jiajun1223/1234/docs/02_壁厚与斜度设计.md

# 壁厚与斜度设计

## 壁厚公式（谐波齿轮传动技术手册 表 3-3）
| 项目 | 公式 | 08 取值(d_RB=20) |
|---|---|---|
| 壁厚 δ | (0.0075~0.0115)·d_RB，取 0.008 | 0.16 |
| 筒壁外径 d_WR | d_RB + 2δ | 20.32 |
| 齿圈宽 b_R | (0.15~0.25)·d_RB，取 0.2 | 4.0 |
| 筒长 L | (0.75~1.0)·d_RB，取 0.8 | 16 |
| 凸缘厚 H | ≥3+0.01·d_RB | 3.2 |
| 齿根下壁厚 δ₁ | (d_fR−d_RB)/2 | 0.61 |
| 圆角 R₁=R₂ / R₃ | 0.05·d_RB / 0.10·d_RB | 1.0 / 2.0 |

## 筒壁斜度
- **0°~0.5°（以等壁为主）**，这是绿的 LCS/LHD 风格：筒体套波发生器要均匀变形，锥度>1° 会倾斜啮合区。
- 若做渐变壁厚：0.3°~0.8°，壁厚比 1.2~1.5。

## 腹板斜度
- 腹板与径向面夹角 **5°~12°（常用 6°~8°）**；两端相切 R≥3δ。

## 底盘（法兰盘）斜度 —— 见 docs/03

## 渐变壁厚原则
- 优先用**样条**（刚度二阶连续），不要"直线锥 + 小圆角"组合。
- 应力逻辑：根部（固支端）弯矩最大 → 厚；齿端需柔 → 薄。
