jiajun1223/1234/docs/05_手册与绿的LCS对标数据.md

# 手册数据与绿的 LCS 对标

## 手册 表 3-2（壁厚系数 δ/d_RB，淬火回火 HRC32~36）
| 速比 u | 合金结构钢 | 弹簧钢 | 中碳钢 |
|---|---|---|---|
| ≤80 | 0.0100 | 0.0095 | 0.0090 |
| 80~160 | 0.0095 | 0.0090 | 0.0085 |
| 160~250 | 0.0090 | 0.0085 | 0.0080 |

## 手册 表 3-3 计算实例（u=100, T=50 N·m, d_RB=60）
| 序号 | 项目 | 公式 | 值 |
|---|---|---|---|
| 1 | 柔轮内径 d_RB | k·∛(T/10) | 60 |
| 2 | 齿圈宽 b_R | (0.15~0.25)d_RB | 12 |
| 3 | 筒长 L | (0.75~1.0)d_RB | 48 |
| 4 | 壁厚 δ | (0.0075~0.0115)d_RB | 0.48 |
| 5 | 筒壁外径 d_WR | d_RB+2δ | 60.96 |
| 6 | 凸缘厚 H | ≥3+0.01d_RB | 4 |
| 8 | 端凸缘 d_T | (0.5~0.65)d_RB | 36 |
| 9~11 | 圆角 R₂/R₁/R₃ | 0.05/0.05/0.10 d_RB | 3/3/6 |
| 12 | 齿顶圆 d_aR | 2m(u+x_R+h_a*) | 62.223 (m=0.3,x_R=3.37,h_a*=0.5) |
| 13 | 齿根圆 d_fR | 2m(u+x_R−h_f*) | 61.212 (h_f*=1.35) |
| 14 | 齿根下壁厚 δ₁ | (d_fR−d_RB)/2 | 0.56 |
| 15 | 壁厚差 Δδ | δ₁−δ | 0.08 |

注：x_R 为变位系数按速比查表；h_a* 取 0.3~0.8；h_f* 滚刀 1.35 / 插齿刀 1.25。

## 绿的式柔轮剖面读数（2° 图纸）
- 壁厚 0.12（齿圈段），2° 过渡，根部加厚 0.11 → 0.23
- 齿圈段 1.7，过渡段 1.2，筒体 4.7
- 腹板 3（径向）×2（轴向）+ R2 相切，底部 R0.3
- 法兰厚 1.5，宽 1.31
- 结论：2° 只作用在约 3 mm 段（1.7+1.2），下面 4.7 段等厚；齿圈段不加厚，加厚靠锥度。

## CSF-14 参考件实测（鑫拓 CSF-14系列柔轮.SLDPRT）
- 包围盒 Ø46.97 × 35.20
- 齿顶 R17.597（Ø35.19）、齿根 R17.227（Ø34.45）
- 齿形圆弧 R0.30（齿顶凸）/ R0.15（齿侧）/ R0.134（齿根凹）
- 齿数 160（速比 80），m≈0.2177
- 其他圆柱面 R16.948 / R17.148 / R11.5 / R5.5 / R2.1×6

## DWG 08-100.dwg 解析
- 版本 r2004，8 图层，2130 实体（440 直线 / 1632 圆弧 / 8 圆 / 2 椭圆 / 2 样条 / 26 尺寸 / 10 多行文字 / 5 块 / 1 多段线 / 4 公差）
- 文本：柔轮 z=200 m=0.105 齿大圆 Ø20.757 齿小圆 Ø20.397；刚轮 z=202 Ø21.151 / Ø20.830；刀盘 180 齿
