jiajun1223/1234/docs/06_尺寸系列参数.md

# 尺寸系列参数（速比 100，z=200/202）

节圆 = 规格号 × 0.1 英寸（0.254 mm）；m = 节圆 / 200。

| 规格 | 节圆 Ø | 模数 m | 柔轮齿顶/齿根 Ø | 柔轮法兰Ø × 总高 | 刚轮齿顶/齿根 Ø | 刚轮外径 × 总高 |
|---|---|---|---|---|---|---|
| 08 | 20.32 / 20.80 | 0.1016 / 0.104 | 20.99 / 20.61 | 40 × 12 | 20.82 / 21.20 | 32 × 6.5 |
| 11 | 22.35 | 0.1118 | — | — | — | — |
| 14 | 35.56 | 0.1778 | 35.88 / 35.24 | 70 × 21 | 35.60 / 36.24 | 56 × 11.4 |
| 17 | 43.18 | 0.2159 | 43.57 / 42.79 | 85 × 25.5 | 43.25 / 44.11 | 68 × 13.8 |
| 20 | 50.80 | 0.2540 | 51.26 / 50.34 | 100 × 30 | 50.90 / 51.90 | 80 × 16.25 |
| 25 | 63.50 | 0.3175 | 64.07 / 62.93 | 125 × 37.5 | 63.62 / 64.88 | 100 × 20.3 |

## 08 号（最终采用 m=0.104）
- 柔轮：Ø40×12，齿圈 z 8~12（200 齿），止口 Ø30.2×1.21，内孔 Ø20.012，筒体 OD Ø20.612 壁厚 0.30
- 刚轮：Ø32×6.5，202 内齿，6×Ø3.2 @ Ø26，齿顶 Ø20.821 / 齿根 Ø21.195

## 模数演变
0.1016（初）→ 0.105（用户）→ 0.103（用户改）→ **0.104（最终）**
