jiajun1223/1234/images/csf14.png

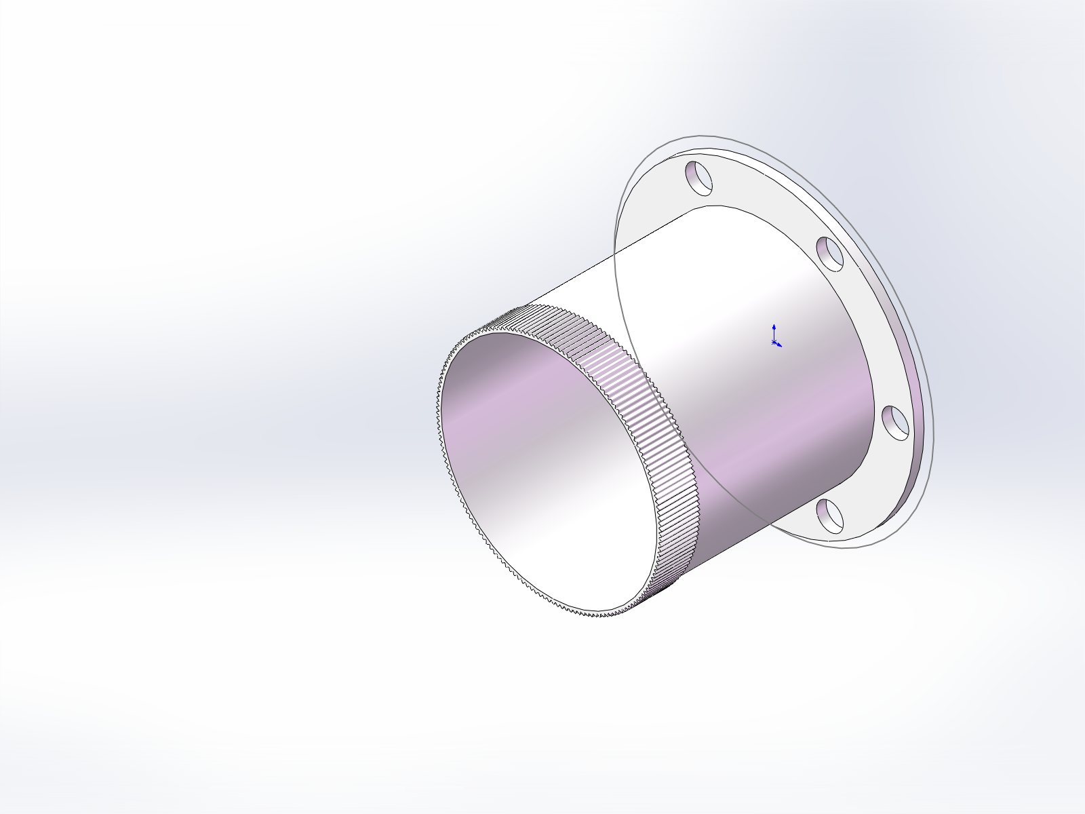
images/csf14.png
