jiajun1223/1234/images/cup11.png

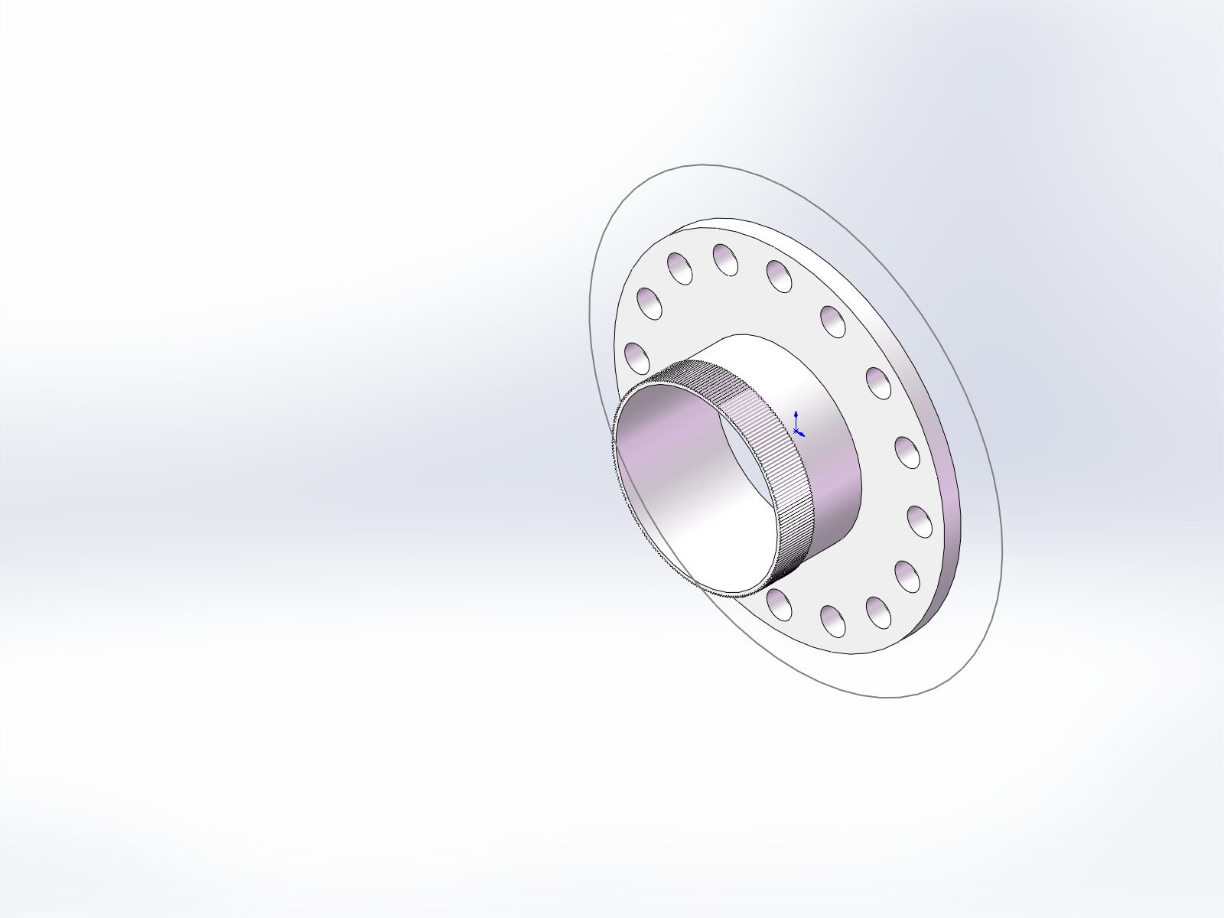
images/cup11.png
