jiajun1223/1234/images/flexspline_shot.png

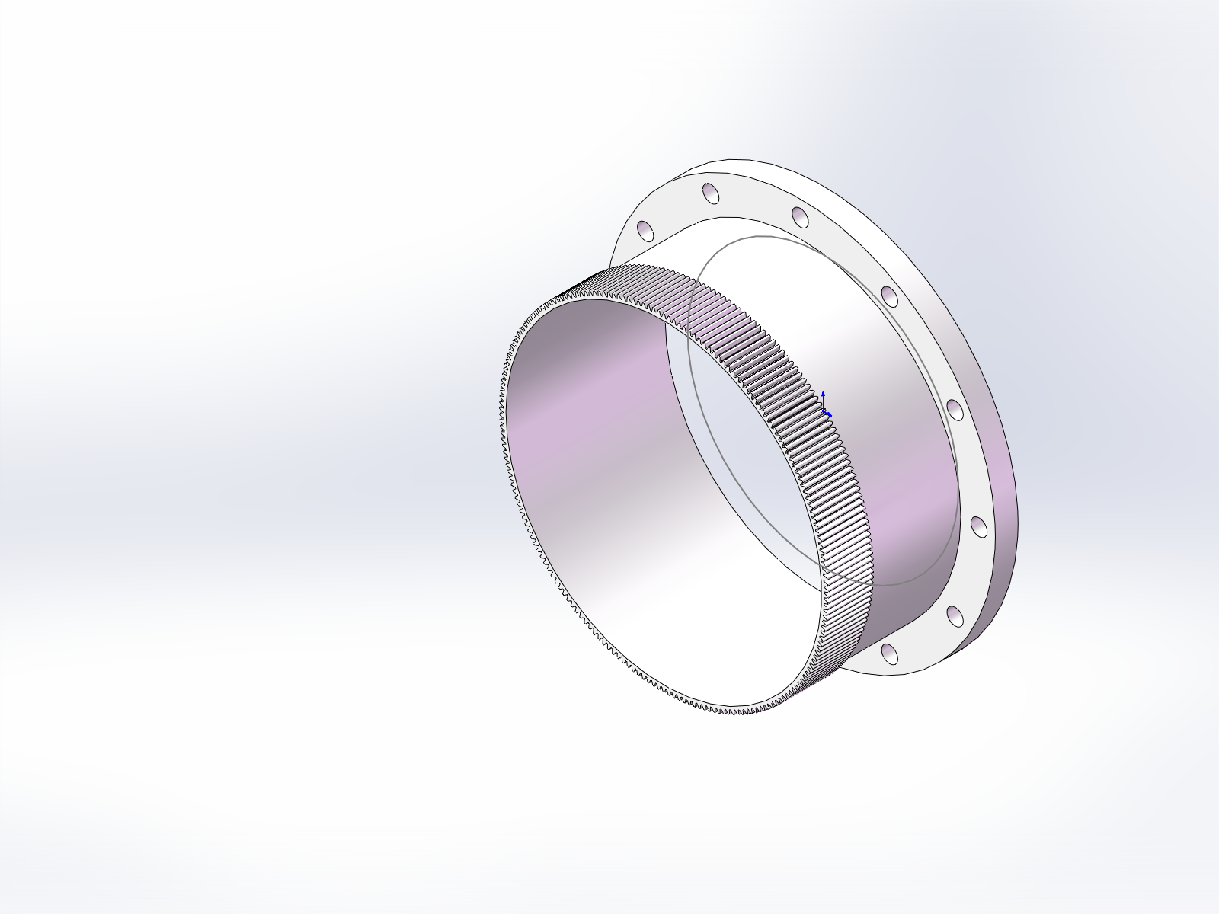
images/flexspline_shot.png
