jiajun1223/1234/images/ring08.png

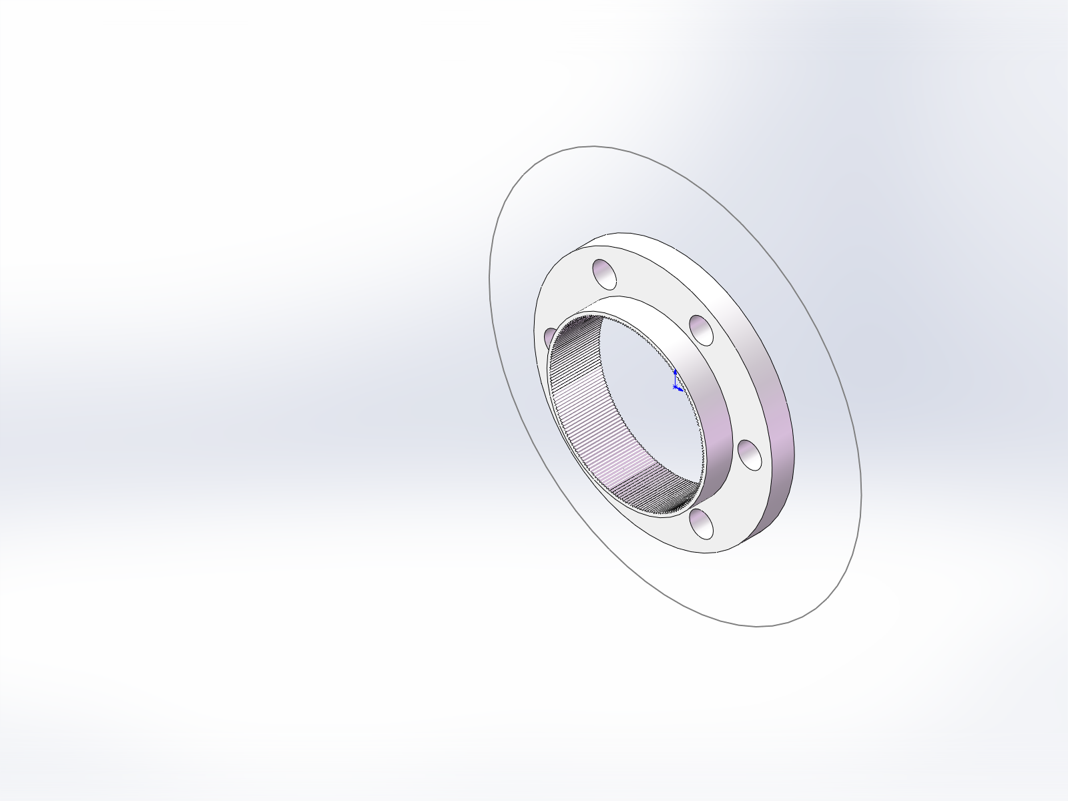
images/ring08.png
