jiajun1223/1234/docs/08_模型文件清单.md

# 模型文件清单（models/ 目录）

## SHD-08（最终 m=0.104，HD系列）
| 文件 | 说明 |
|---|---|
| SHD-08-P齿柔轮_m0.104.SLDPRT | 杯型柔轮（等壁 0.30 版） |
| SHD-08-P齿刚轮_m0.104.SLDPRT | 刚轮 202 内齿 |
| SHD-08-P齿柔轮_m0.104.SLDPRT实验.SLDPRT | 柔轮实验基准（Ø40×12，底盘改斜度都以此为母版） |
| SHD-08-P齿柔轮_m0.104_底盘渐变.SLDPRT | 底盘上表面 2° 内斜（早期，方向正确、角度后被讨论） |
| SHD-08-P齿柔轮_m0.104_渐变壁厚.SLDPRT | 内孔渐变壁厚（方向错误：改了内壁，已否） |
| SHD-08-P齿柔轮_m0.104_三段渐变底盘.SLDPRT | 底盘三段内厚外薄（方向错误：应外厚内薄） |
| SHD-08-P齿柔轮_m0.104_外厚内薄底盘.SLDPRT | 底盘三段外厚内薄（方向正确，中间仍是直锥，待改 R19 圆弧） |
| SHD-08_礼帽柔轮_绿的对标.SLDPRT | 礼帽型对标版 |
| SHD-08-P齿刚轮_m0.103/m0.105.SLDPRT | 刚轮其它模数版本 |
| *.DXF | 对应 2D 图纸 |

## 其他规格（速比 100）
- SHD-11 / 14 / 17 / 20 / 25 的 _P齿杯型柔轮 + _P齿刚轮

## 参考/试验（models 不收录，仅列名）
- CSF-14_杯型柔轮.SLDPRT（Ø46.97×35.2，160 齿，参照鑫拓 CSF-14）
- LCS-14_礼帽柔轮_渐变壁厚.SLDPRT、LHD-14_中空翻边柔轮.SLDPRT
- workspace 里的 SHD-08-100柔轮_双圆弧齿_最终.SLDPRT（m=0.1016 早期完整版）

## 关键尺寸速查（SHD-08 柔轮，m=0.104）
外形 Ø40×12；止口 Ø30.2×1.31；内孔 Ø20.012；筒体 Ø20.612 壁厚 0.30（z 2~8）；齿圈 z 8~12（200 齿，齿顶 Ø20.987/齿根 Ø20.613）。
