jiajun1223/1234/models/SHD-08_礼帽柔轮_绿的对标.SLDPRT

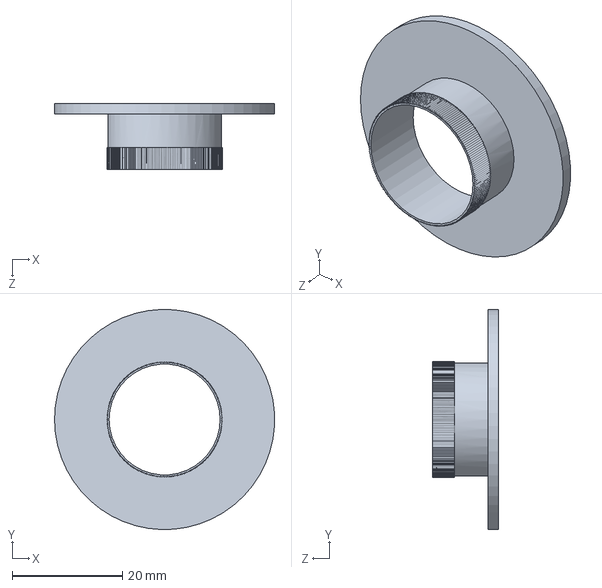
[picture p5: CAD file, 2026-11-09]
models/SHD-08_礼帽柔轮_绿的对标.SLDPRT
40.0 x 40.0 x 12.0 mm
