jiajun1223/1234/models/SHD-20_P齿杯型柔轮.SLDPRT

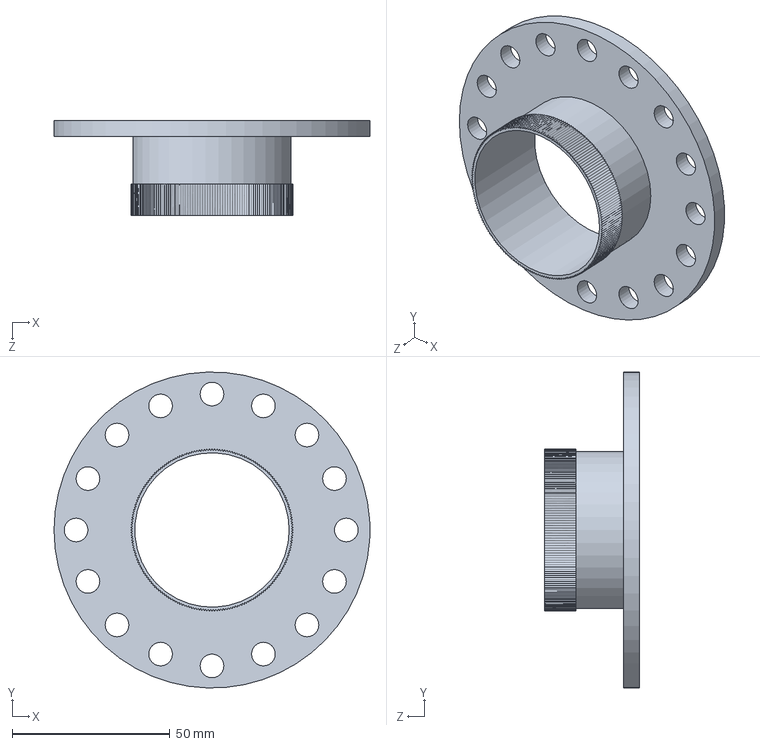
[picture p6: CAD file, 2026-11-09]
models/SHD-20_P齿杯型柔轮.SLDPRT
100.0 x 100.0 x 30.0 mm
