jiajun1223/1234/models/SHD-11_P齿刚轮.SLDPRT

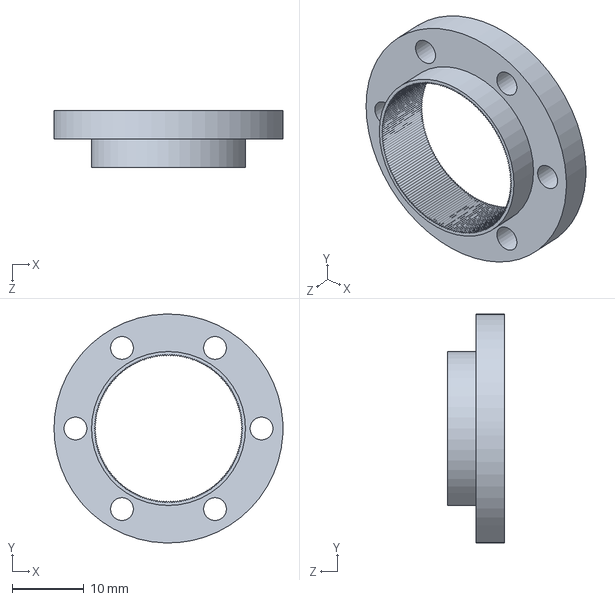
[picture p7: CAD file, 2026-11-09]
models/SHD-11_P齿刚轮.SLDPRT
32.0 x 32.0 x 8.00 mm
