jiajun1223/1234/models/SHD-17_P齿杯型柔轮.SLDPRT

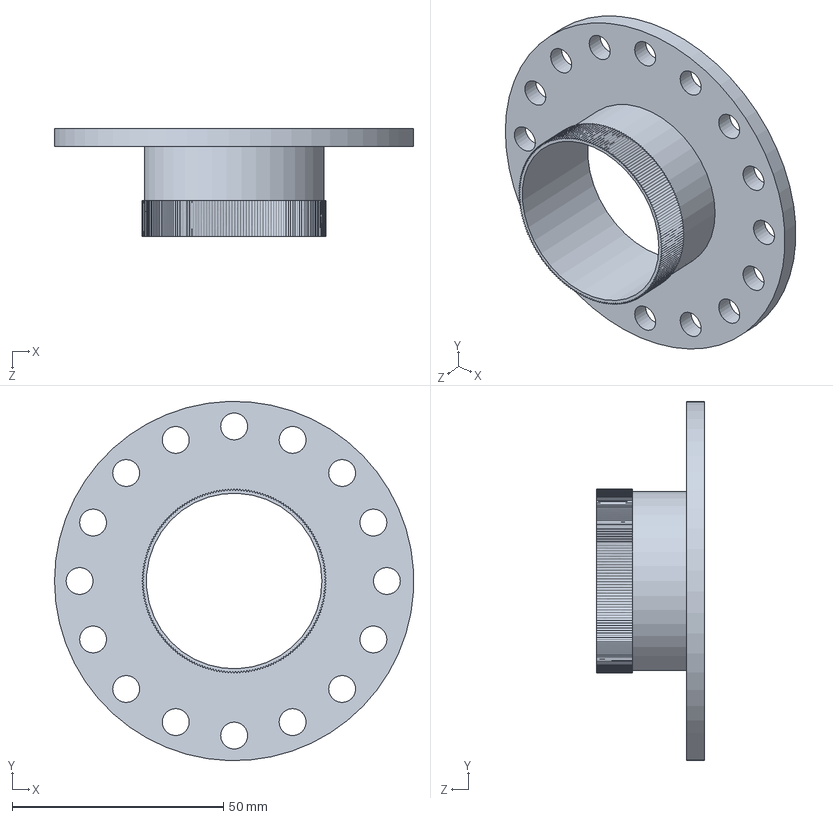
[picture p8: CAD file, 2026-11-09]
models/SHD-17_P齿杯型柔轮.SLDPRT
84.9 x 85.0 x 25.5 mm
