jiajun1223/1234/models/SHD-20_P齿刚轮.SLDPRT

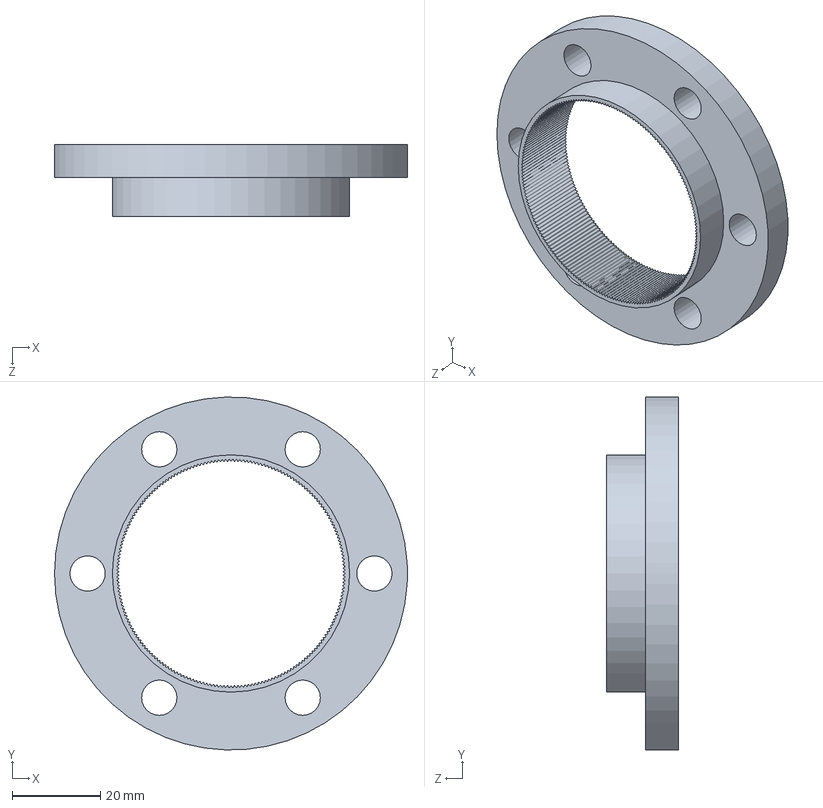
[picture p9: CAD file, 2026-11-09]
models/SHD-20_P齿刚轮.SLDPRT
80.0 x 80.0 x 16.2 mm
