jiajun1223/1234/models/SHD-11_P齿杯型柔轮.SLDPRT

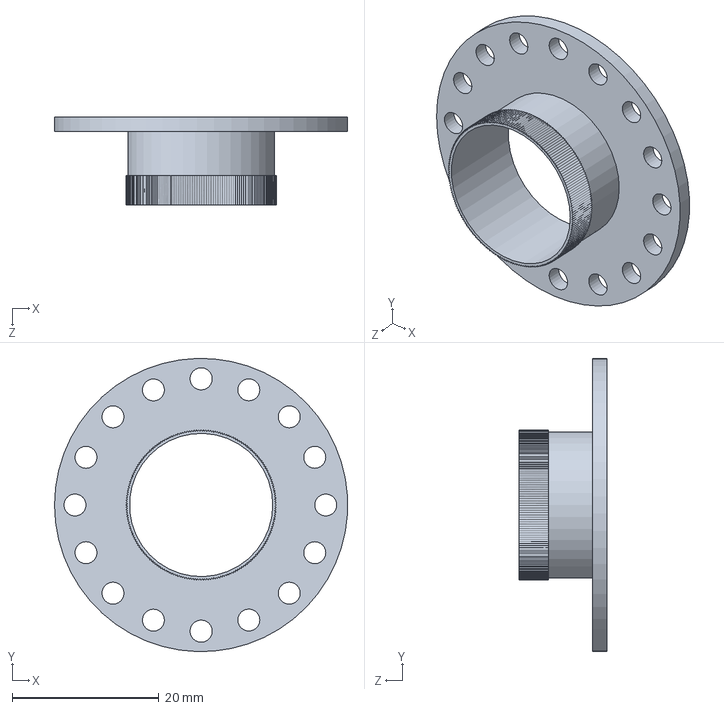
[picture p10: CAD file, 2026-11-09]
models/SHD-11_P齿杯型柔轮.SLDPRT
40.0 x 40.0 x 12.0 mm
