jiajun1223/1234/models/SHD-14_P齿刚轮.SLDPRT

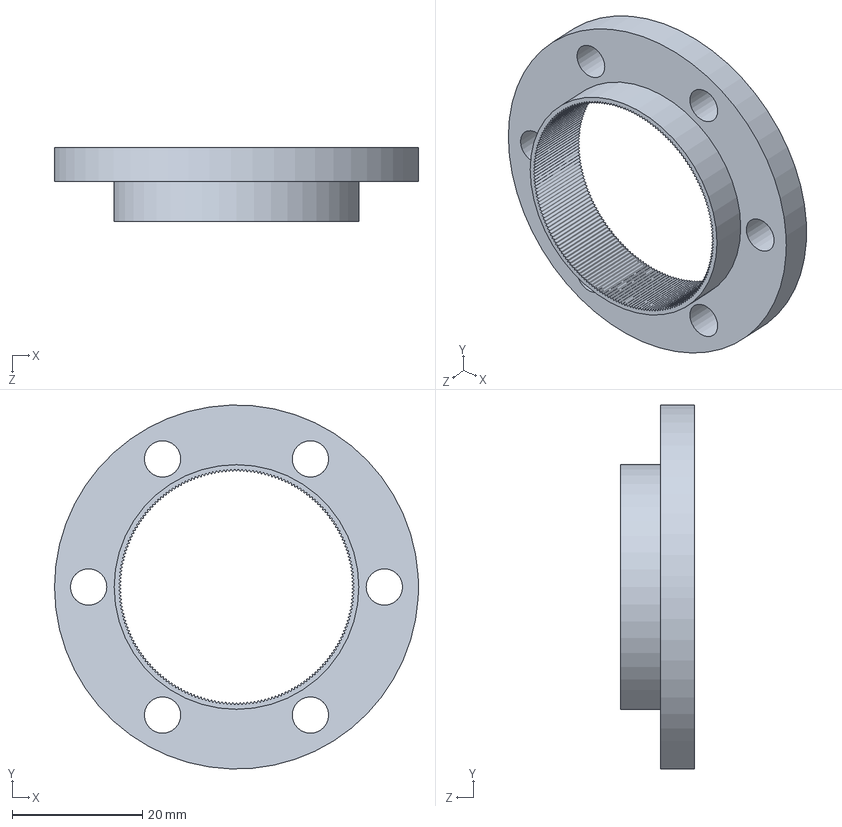
[picture p11: CAD file, 2026-11-09]
models/SHD-14_P齿刚轮.SLDPRT
56.0 x 56.0 x 11.4 mm
