jiajun1223/1234/models/SHD-17_P齿刚轮.SLDPRT

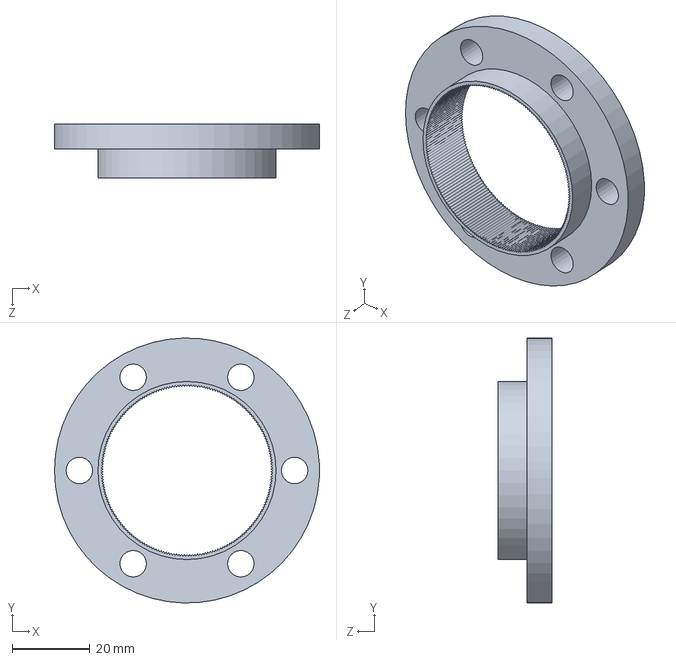
[picture p12: CAD file, 2026-11-09]
models/SHD-17_P齿刚轮.SLDPRT
68.0 x 68.0 x 13.8 mm
