jiajun1223/1234/models/SHD-08-P齿柔轮_m0.104_外厚内薄底盘.SLDPRT

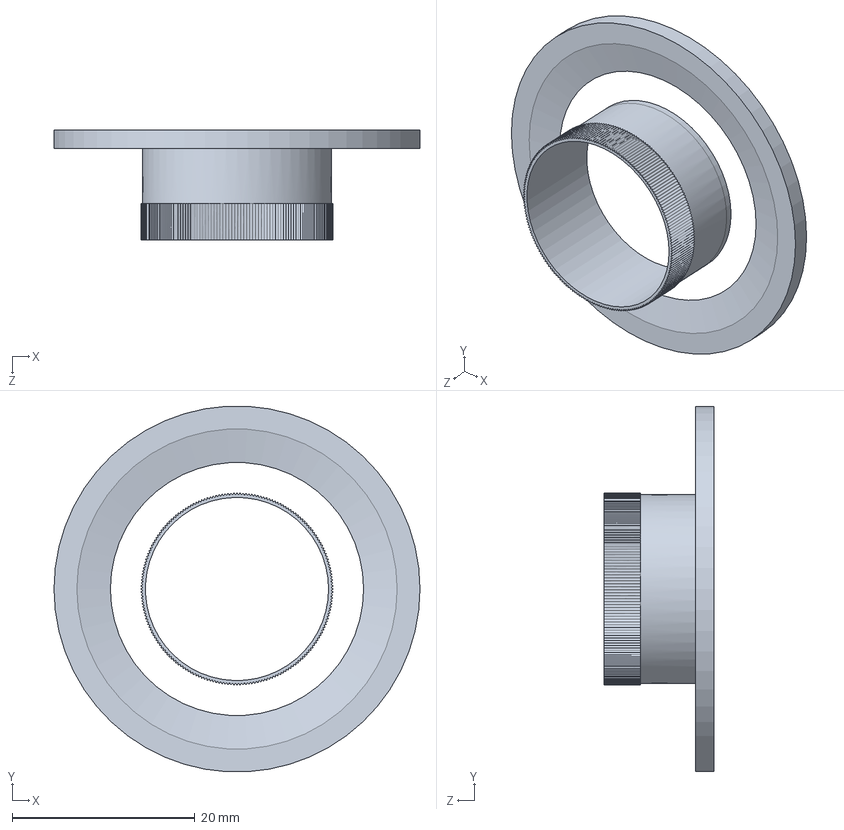
[picture p13: CAD file, 2026-11-09]
models/SHD-08-P齿柔轮_m0.104_外厚内薄底盘.SLDPRT
40.0 x 39.9 x 12.0 mm
