jiajun1223/1234/models/SHD-08-P齿柔轮.SLDPRT

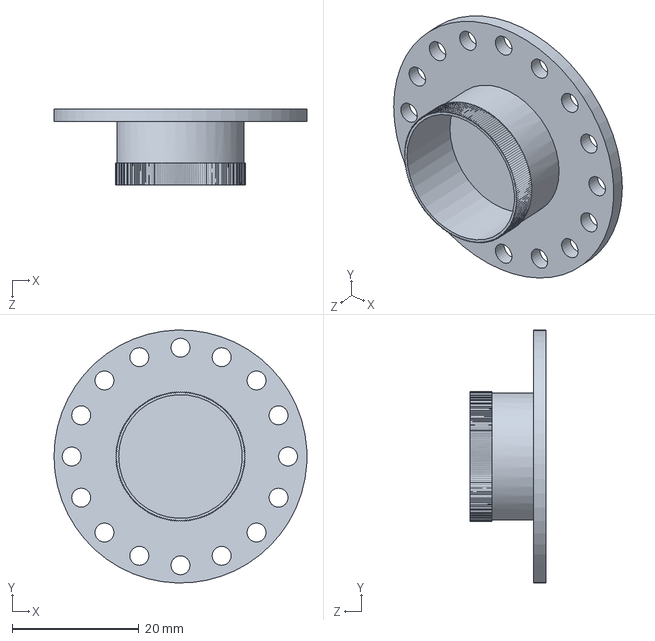
[picture p14: CAD file, 2026-11-09]
models/SHD-08-P齿柔轮.SLDPRT
40.0 x 40.0 x 12.0 mm
