jiajun1223/1234/models/SHD-25_P齿刚轮.SLDPRT

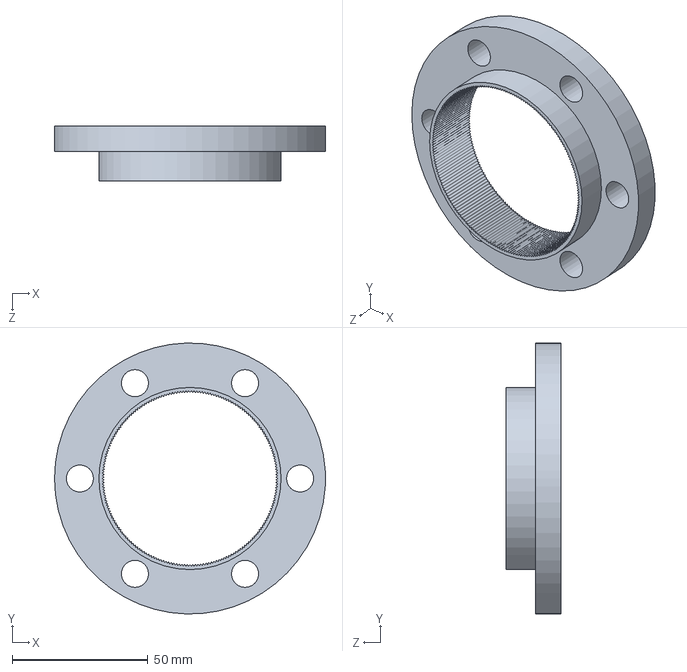
[picture p15: CAD file, 2026-11-09]
models/SHD-25_P齿刚轮.SLDPRT
100.0 x 100.0 x 20.3 mm
