jiajun1223/1234/models/SHD-08-P齿刚轮_m0.104.SLDPRT

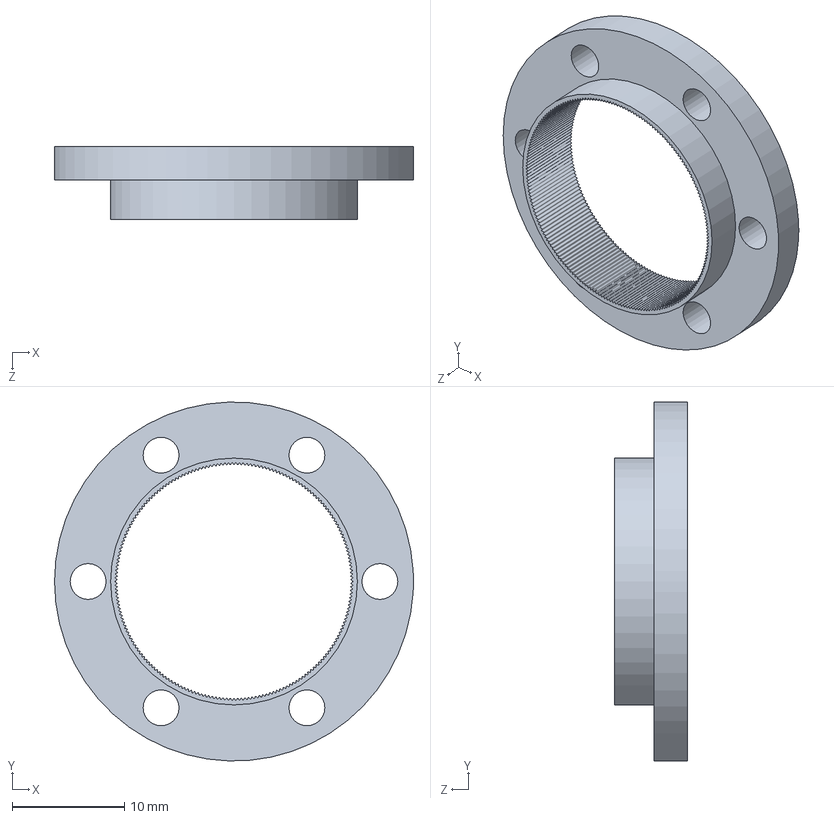
[picture p16: CAD file, 2026-11-09]
models/SHD-08-P齿刚轮_m0.104.SLDPRT
32.0 x 32.0 x 6.50 mm
