jiajun1223/1234/models/SHD-25_P齿杯型柔轮.SLDPRT

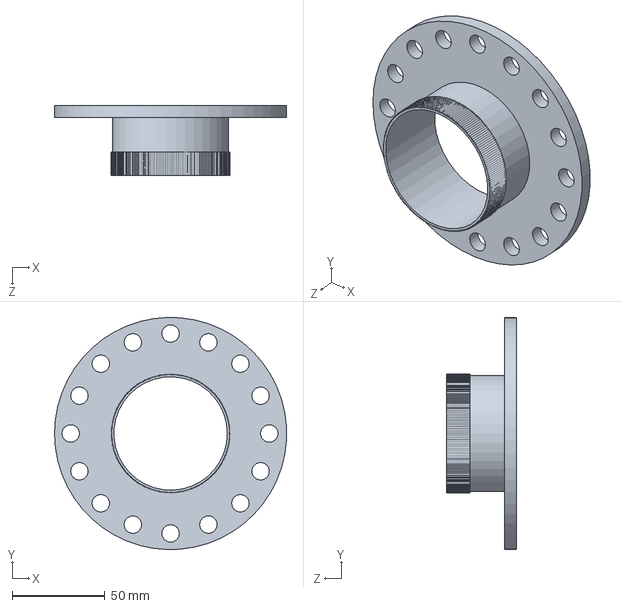
[picture p17: CAD file, 2026-11-09]
models/SHD-25_P齿杯型柔轮.SLDPRT
124.9 x 124.9 x 37.5 mm
