jiajun1223/1234/models/SHD-14_P齿杯型柔轮.SLDPRT

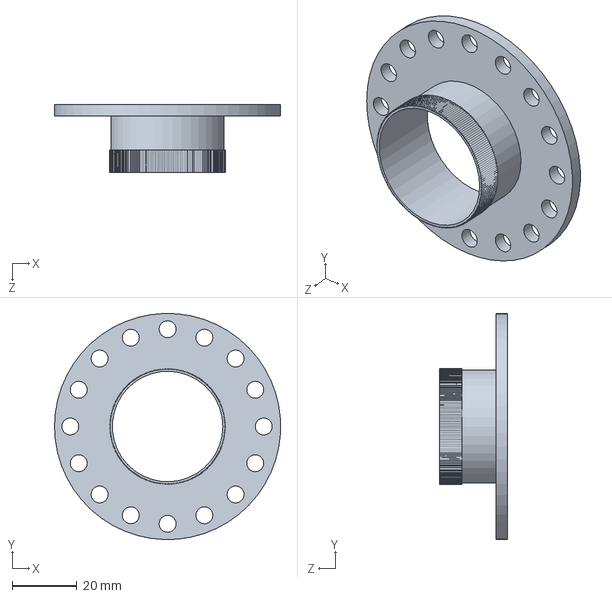
[picture p18: CAD file, 2026-11-09]
models/SHD-14_P齿杯型柔轮.SLDPRT
69.9 x 70.0 x 21.0 mm
