jiajun1223/1234/(list of files, cad)

Other CAD files:
reference/08-100.dwg
models/SHD-08-P齿柔轮_m0.104.SLDPRT实验.SLDPRT
models/SHD-08-P齿柔轮_m0.104_渐变壁厚.SLDPRT
models/SHD-08-P齿柔轮_m0.104.SLDPRT
models/SHD-08-P齿柔轮_m0.104_底盘渐变.SLDPRT
models/SHD-08-P齿柔轮_m0.104_三段渐变底盘.SLDPRT
models/SHD-08-P齿刚轮_m0.104.DXF
models/SHD-08-P齿柔轮.DXF
models/SHD-08-P齿柔轮_m0.104.DXF
models/SHD-11_P齿刚轮.DXF
models/SHD-11_P齿杯型柔轮.DXF
