jiajun1223/1234/docs/09_对话关键决策日志.md

# 对话关键决策日志（用户纠正过 / 必须遵守）

按时间顺序，**带 ⚠️ 的是用户纠正、不能再犯**：

1. 齿形：对标绿的 P 齿 / HD S 齿，无公切线全光滑双圆弧；禁止渐开线、公切线平底。
2. 模数：0.105 → 0.103 → **0.104（最终）**（用户连续改模数）。
3. 柔轮中间应中空（完全贯穿），后来加"先不要 16 个螺栓孔""止口 Ø30.6 深 1.31"。
4. ⚠️ 筒壁：曾画"大圆"（法兰处大圆角）→ 用户"不要大圆，跟 08 一样直筒"。
5. ⚠️ 礼帽 vs 杯型：曾做成礼帽（大法兰小短筒）→ 用户"这是礼帽型我要的是杯型"。
6. ⚠️ 底盘斜度位置：两次改错——先改内孔（"内壁不能变"）、后做内厚外薄（"不应该是由外到内逐渐变薄吗"）。
   **正确 = 底盘上表面，由外到内逐渐变薄（外厚内薄）。**
7. ⚠️ 三段式中间直锥：用户"中间不方便加工，做成平缓弧度"→ 圆弧 R19（或 S 形 R25×2）。
8. 底盘角度：不是照搬图纸 2°，要按国内最新技术等强度设计 → 直线 8°~12° / 圆弧 R18~20 / S R25×2。
9. 刚轮齿数 = 柔轮 + 2；刚轮齿槽凹/齿顶凸（内齿）。
10. 装配：AddComponent5/4 返回 NULL（SW 环境问题），装配未完成，改走单体建模。
11. 手册壁厚公式 δ=0.008·d_RB；但用户后来要求按"国内最新技术"而非手册。

## 工具链决策
- 装了 DSH 插件市场 + 10 个插件（详见 README）。
- SW 自动化优先用 dsh-sw-cad MCP；wincu UI 自动化做兜底。
